Yashwant-Rajesh/Bandgap-Reference-BGR-Low-Dropout-Regulator-LDO-Circuit-/BGR_LDO_Combo_Tests/Full_Chain_LDO_Rail_Sweep.png

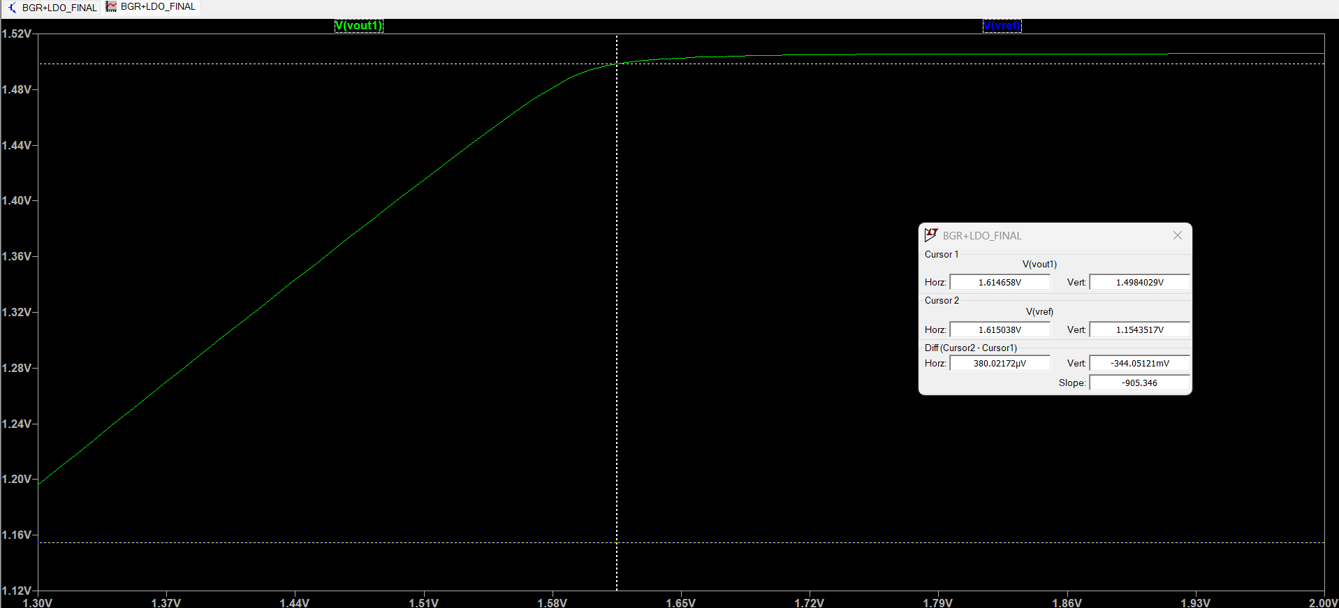
BGR_LDO_Combo_Tests/Full_Chain_LDO_Rail_Sweep.png
