Yashwant-Rajesh/Bandgap-Reference-BGR-Low-Dropout-Regulator-LDO-Circuit-/BGR_LDO_Combo_Tests/Full_Chain_Load_Transient.png

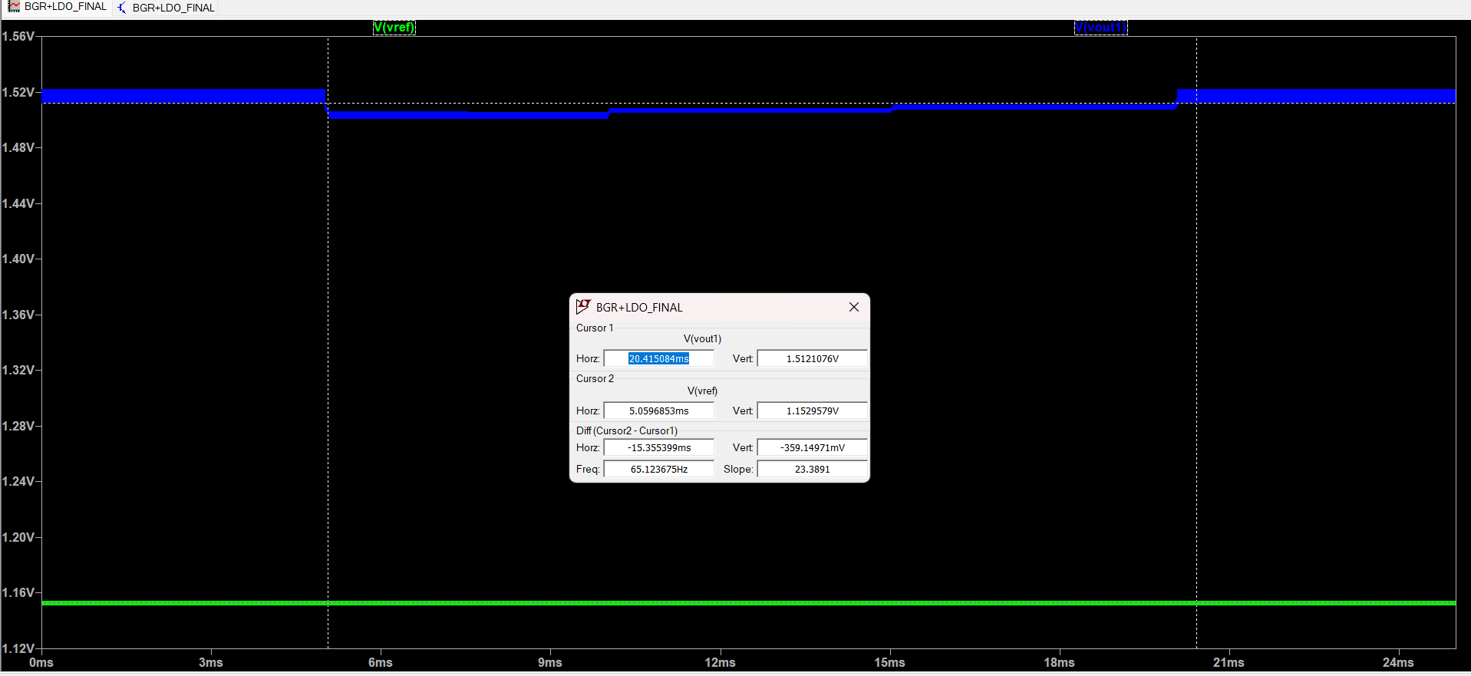
BGR_LDO_Combo_Tests/Full_Chain_Load_Transient.png
