Yashwant-Rajesh/Bandgap-Reference-BGR-Low-Dropout-Regulator-LDO-Circuit-/BGR_LDO_Combo_Tests/Full_Chain_Startup_Baseline.png

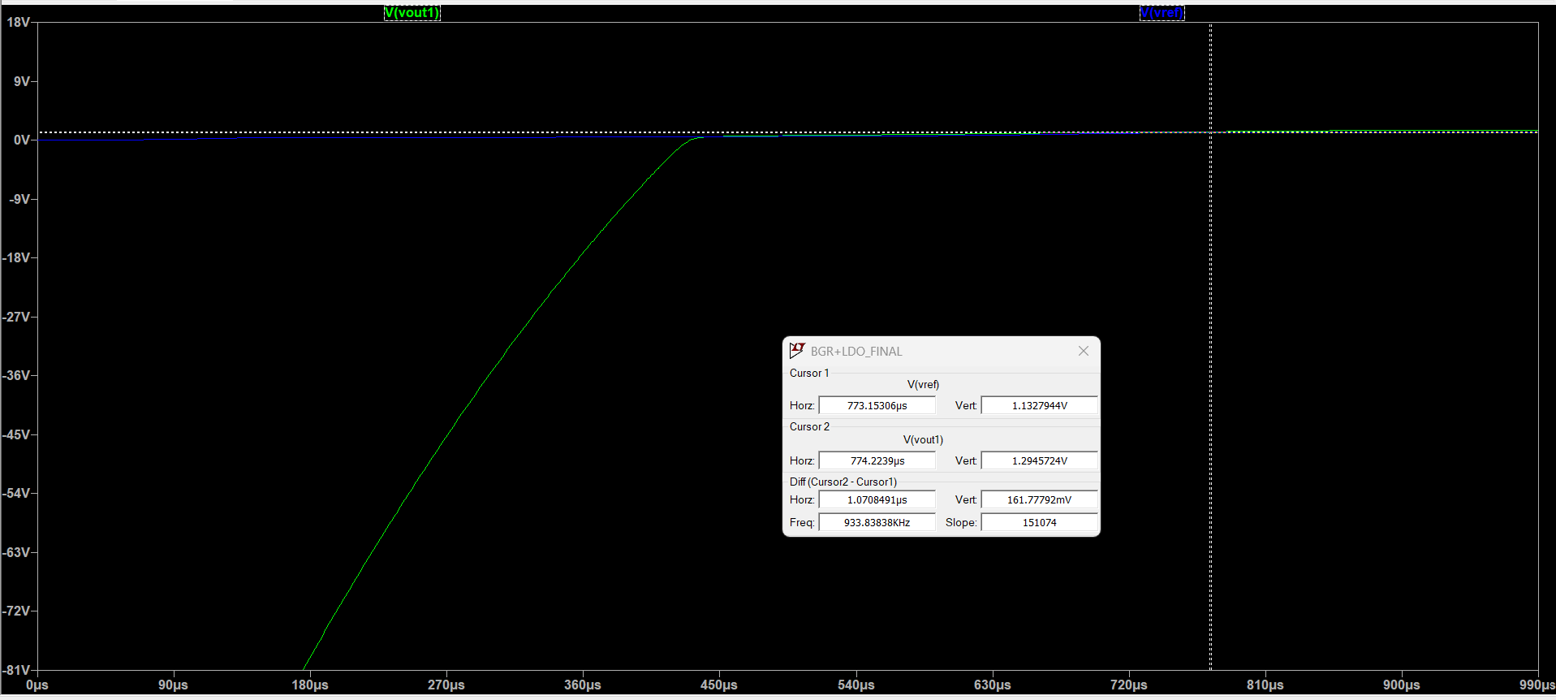
BGR_LDO_Combo_Tests/Full_Chain_Startup_Baseline.png
