Yashwant-Rajesh/Bandgap-Reference-BGR-Low-Dropout-Regulator-LDO-Circuit-/BGR_Tests/27 C Startup.png

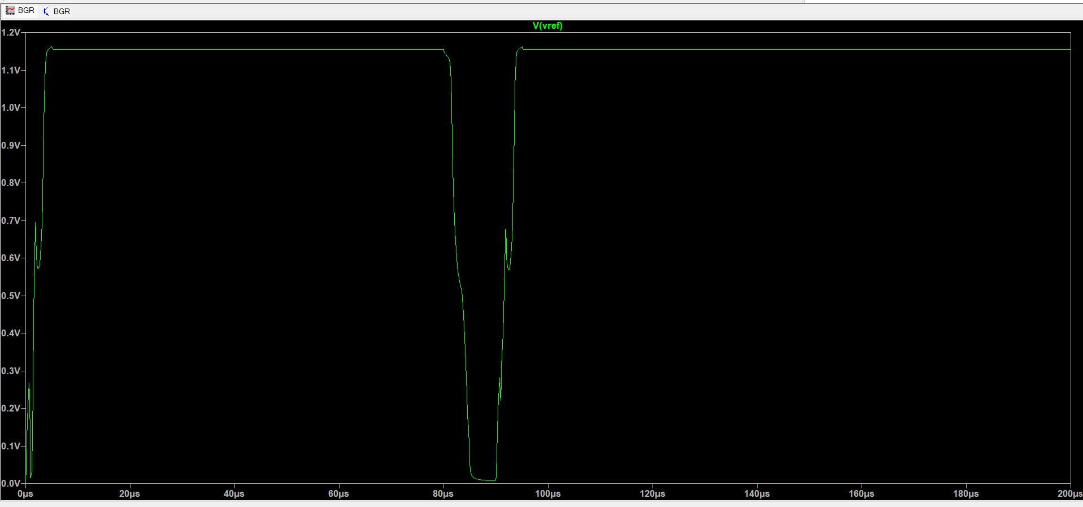
BGR_Tests/27 C Startup.png
