Yashwant-Rajesh/Bandgap-Reference-BGR-Low-Dropout-Regulator-LDO-Circuit-/BGR_Tests/Line Regulation.png

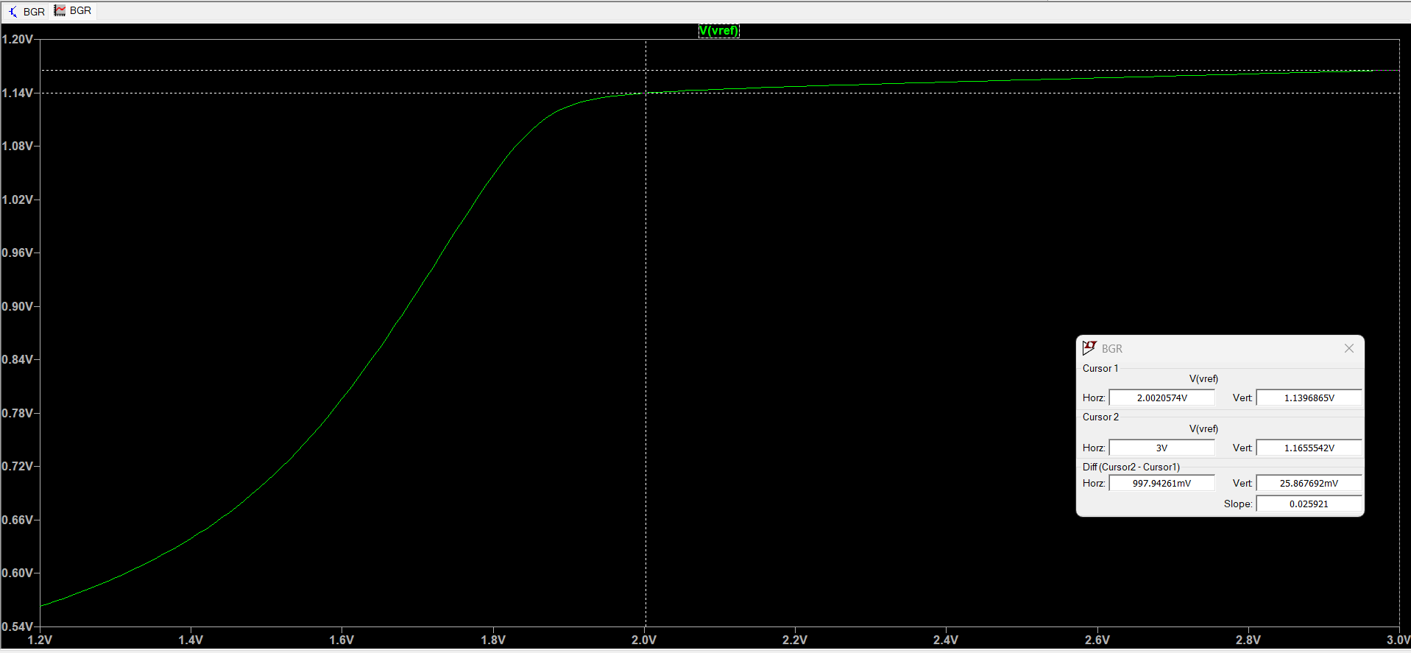
BGR_Tests/Line Regulation.png
