Yashwant-Rajesh/Bandgap-Reference-BGR-Low-Dropout-Regulator-LDO-Circuit-/BGR_Tests/Normal Ramp Startup.png

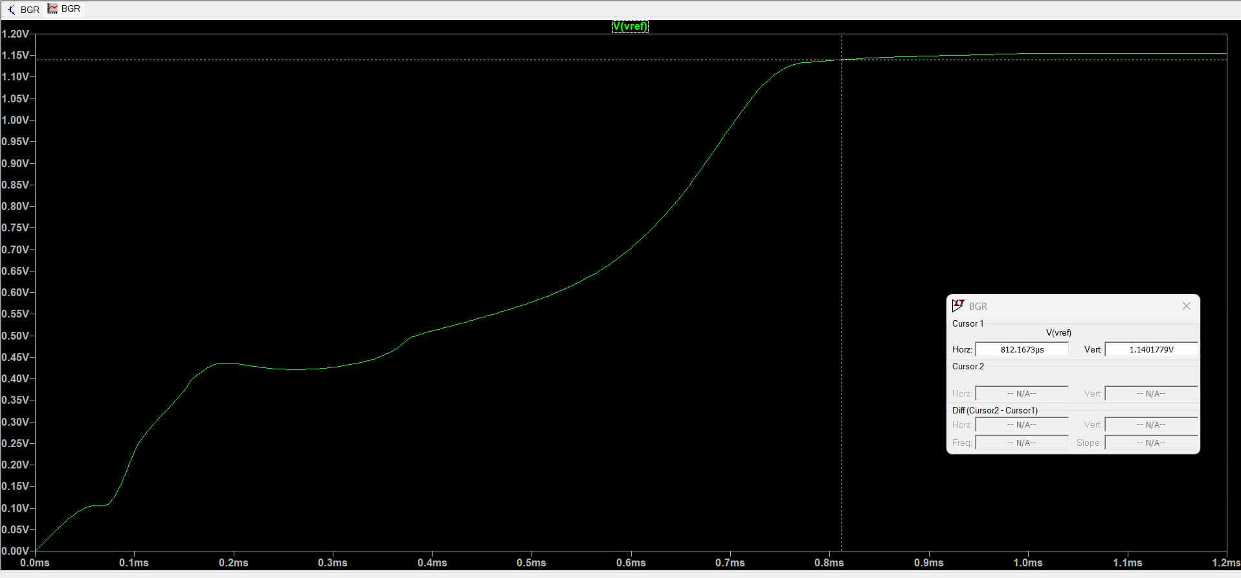
BGR_Tests/Normal Ramp Startup.png
