Yashwant-Rajesh/Bandgap-Reference-BGR-Low-Dropout-Regulator-LDO-Circuit-/BGR_Tests/Power Cycling Restart.png

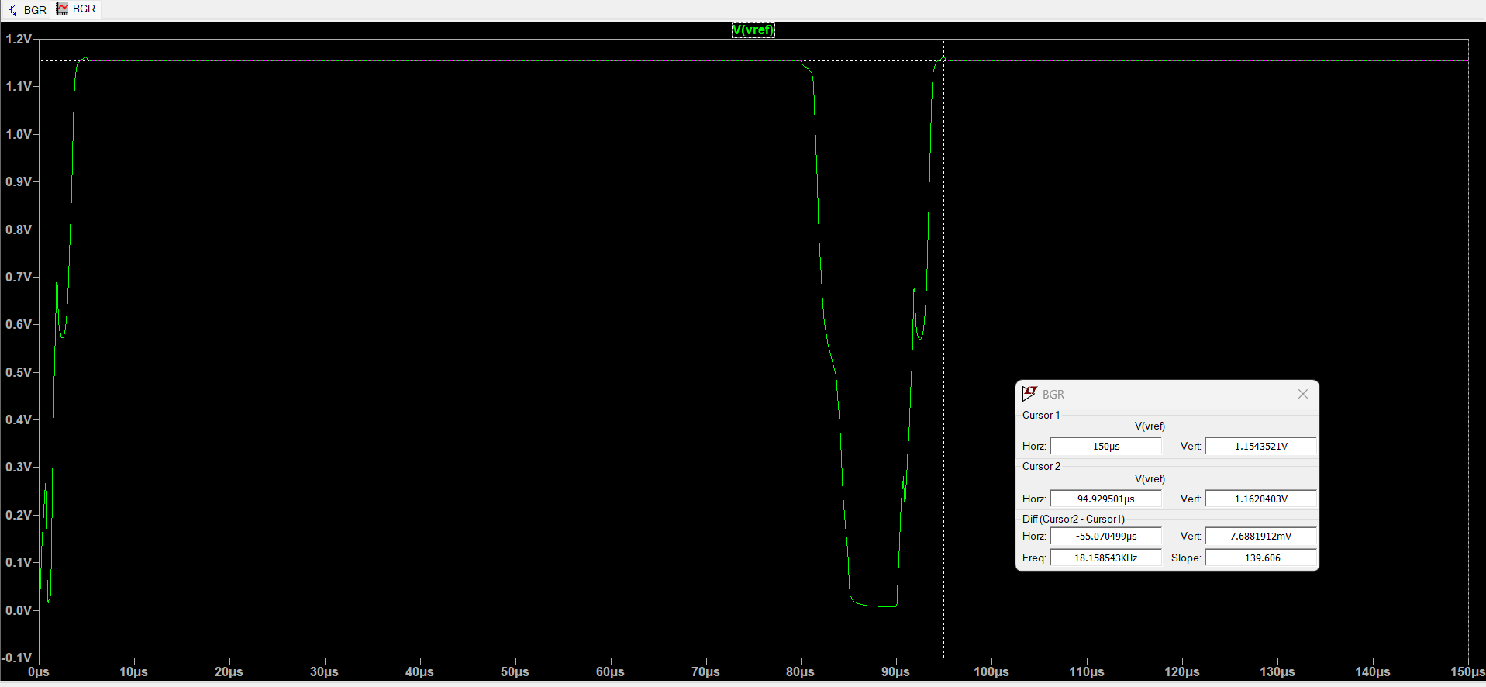
BGR_Tests/Power Cycling Restart.png
