Yashwant-Rajesh/Bandgap-Reference-BGR-Low-Dropout-Regulator-LDO-Circuit-/BGR_Tests/Temperature Coefficient.png

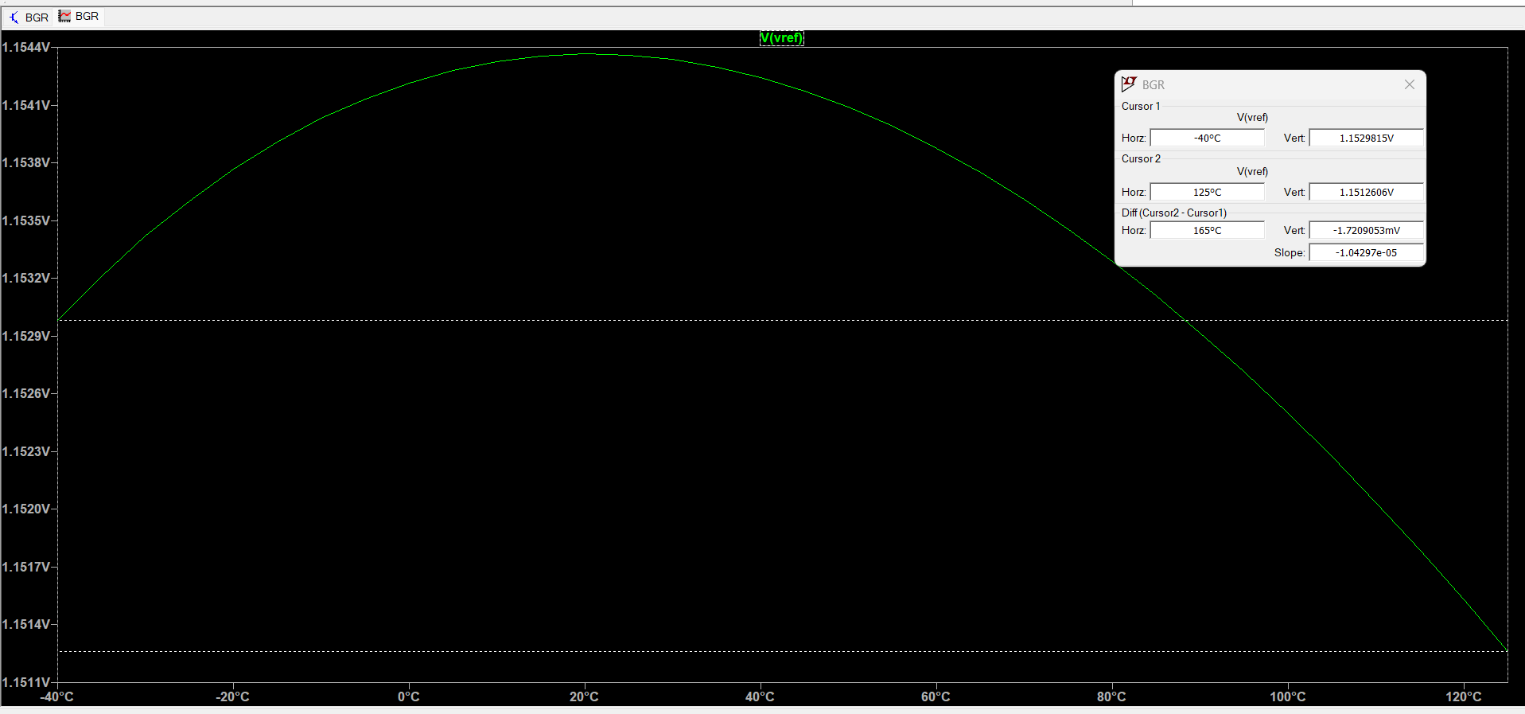
BGR_Tests/Temperature Coefficient.png
