Yashwant-Rajesh/Bandgap-Reference-BGR-Low-Dropout-Regulator-LDO-Circuit-/BGR_Tests/Worst Case Startup.png

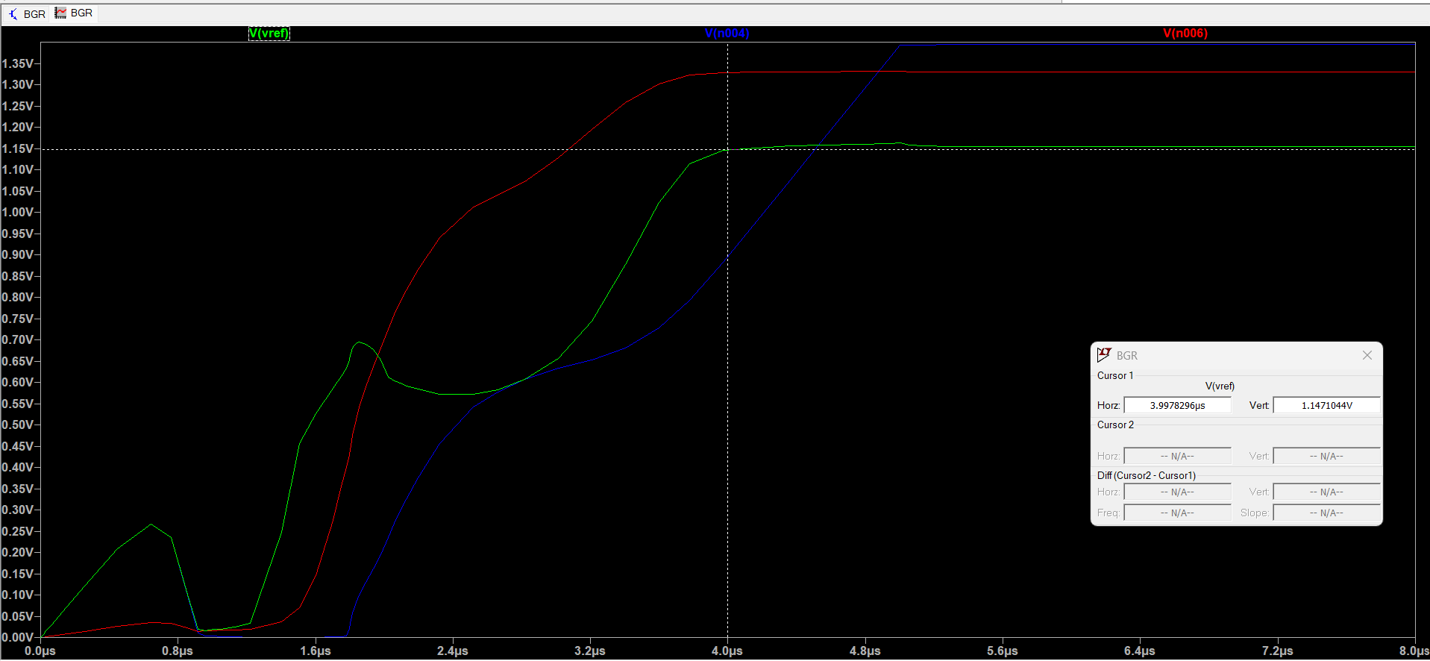
BGR_Tests/Worst Case Startup.png
