Yashwant-Rajesh/Bandgap-Reference-BGR-Low-Dropout-Regulator-LDO-Circuit-/LDO_Tests/Dropout_voltage_LDO.png

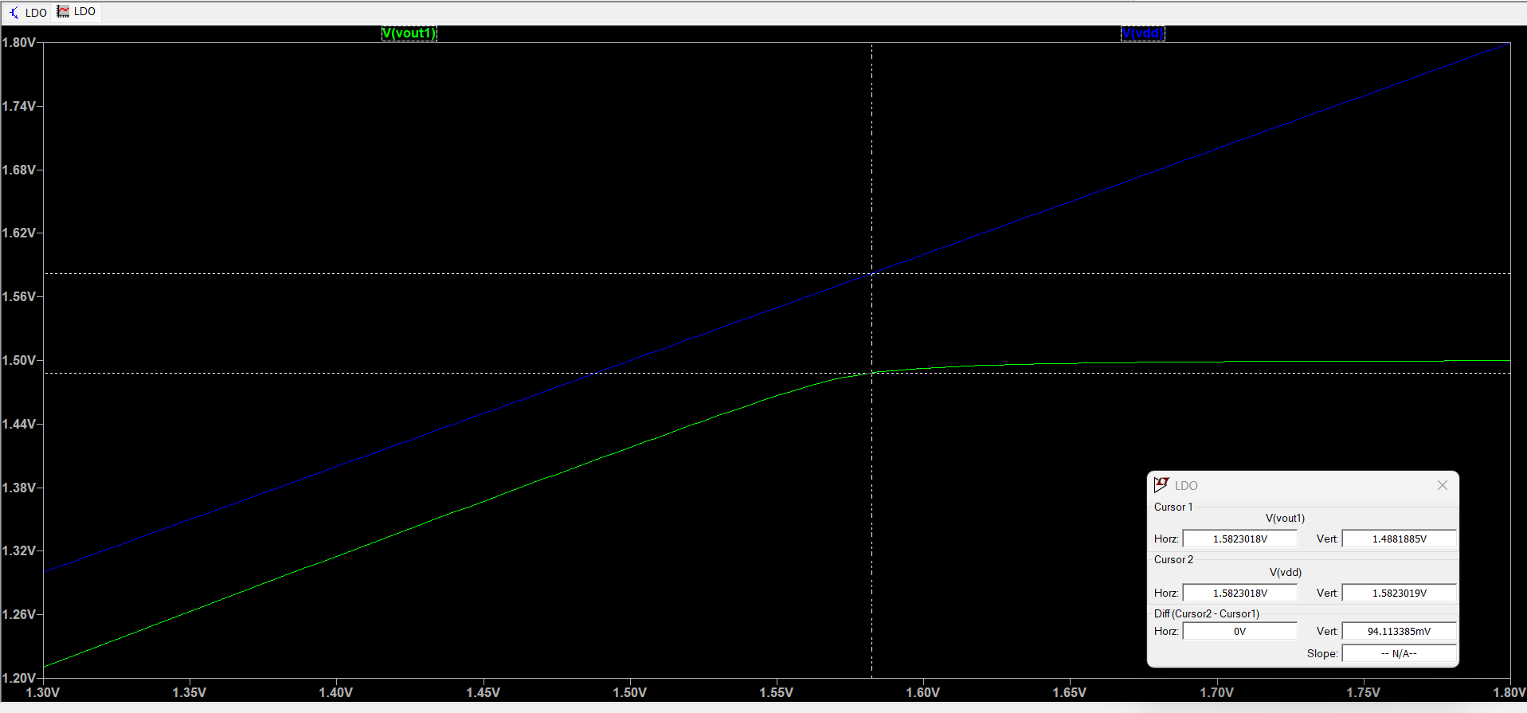
LDO_Tests/Dropout_voltage_LDO.png
