Yashwant-Rajesh/Bandgap-Reference-BGR-Low-Dropout-Regulator-LDO-Circuit-/LDO_Tests/Line_regulation_LDO.png

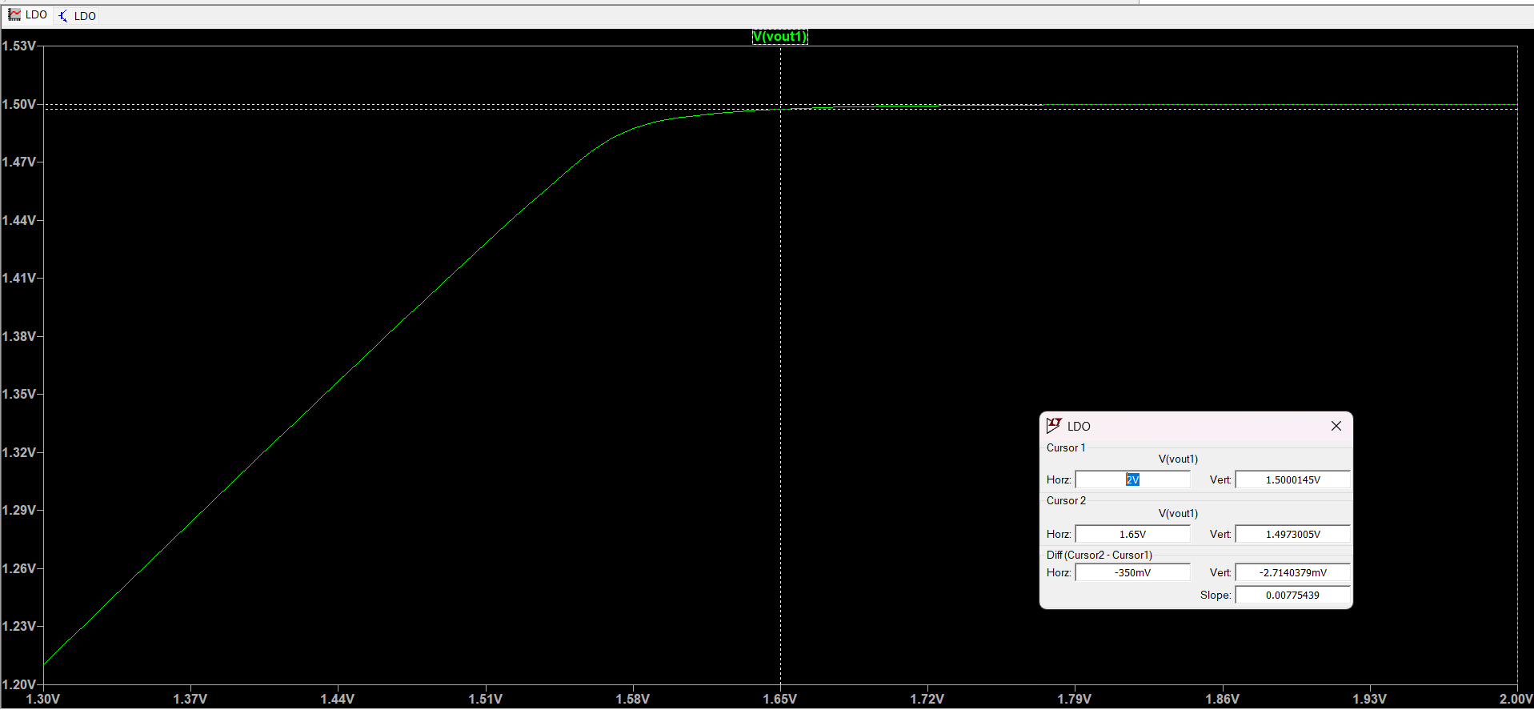
LDO_Tests/Line_regulation_LDO.png
