Yashwant-Rajesh/Bandgap-Reference-BGR-Low-Dropout-Regulator-LDO-Circuit-/LDO_Tests/Line_Transient_LDO.png

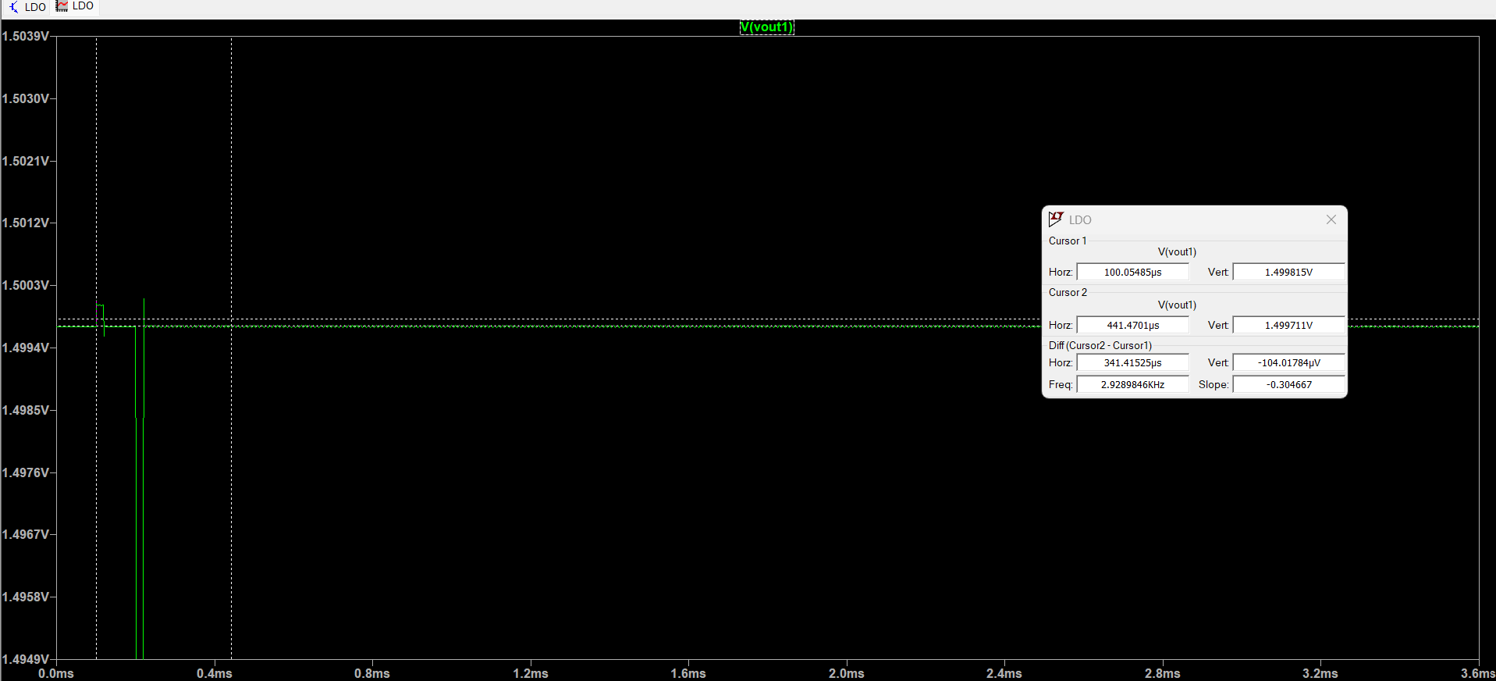
LDO_Tests/Line_Transient_LDO.png
