Yashwant-Rajesh/Bandgap-Reference-BGR-Low-Dropout-Regulator-LDO-Circuit-/LDO_Tests/Load_transient_LDO.png

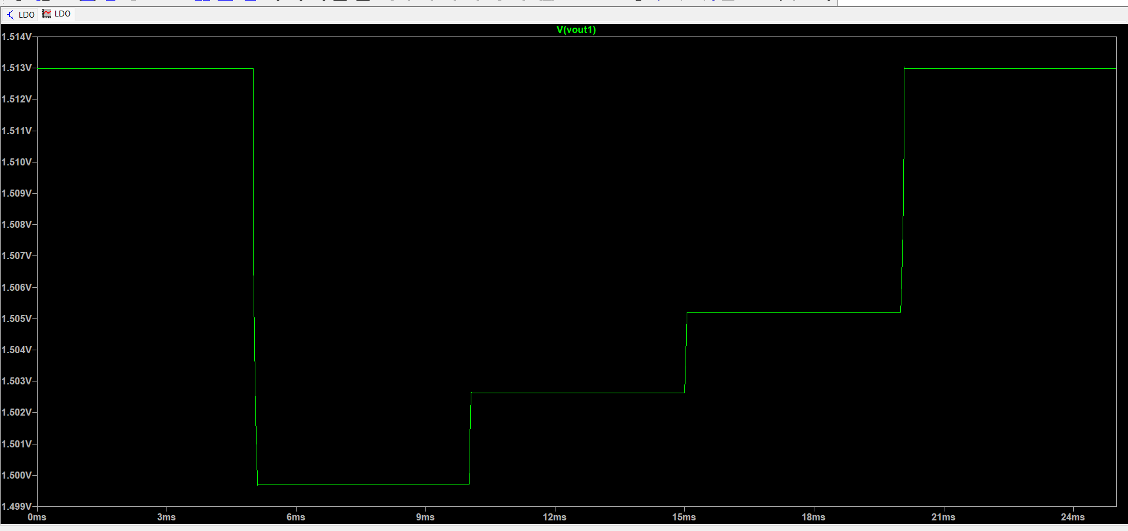
LDO_Tests/Load_transient_LDO.png
