Yashwant-Rajesh/Bandgap-Reference-BGR-Low-Dropout-Regulator-LDO-Circuit-/LDO_Tests/PSRR_LDO.png

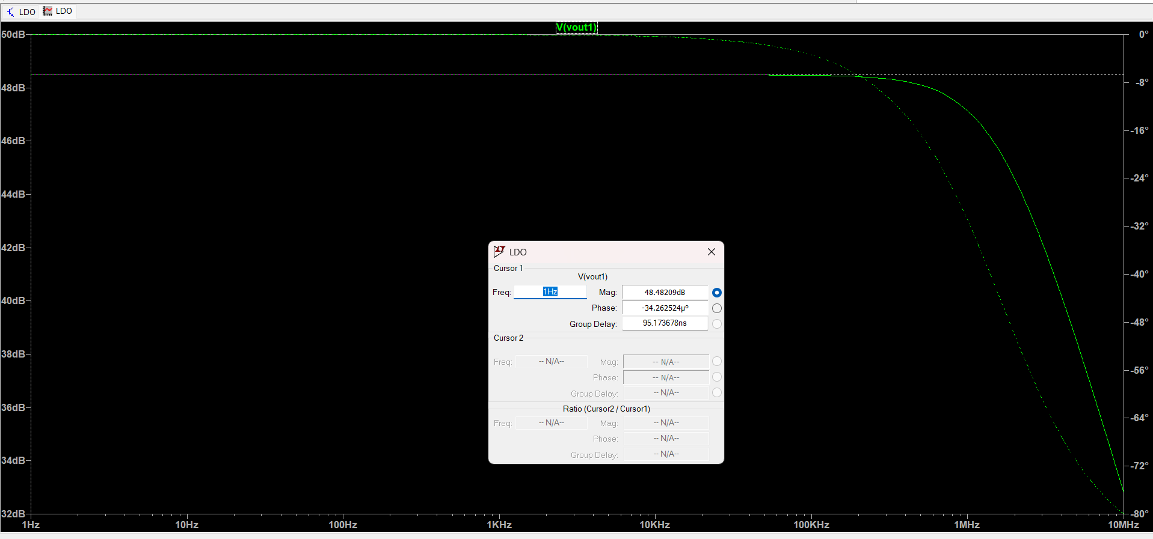
LDO_Tests/PSRR_LDO.png
