Yashwant-Rajesh/Bandgap-Reference-BGR-Low-Dropout-Regulator-LDO-Circuit-/LDO_Tests/Startup_transient_LDO.png

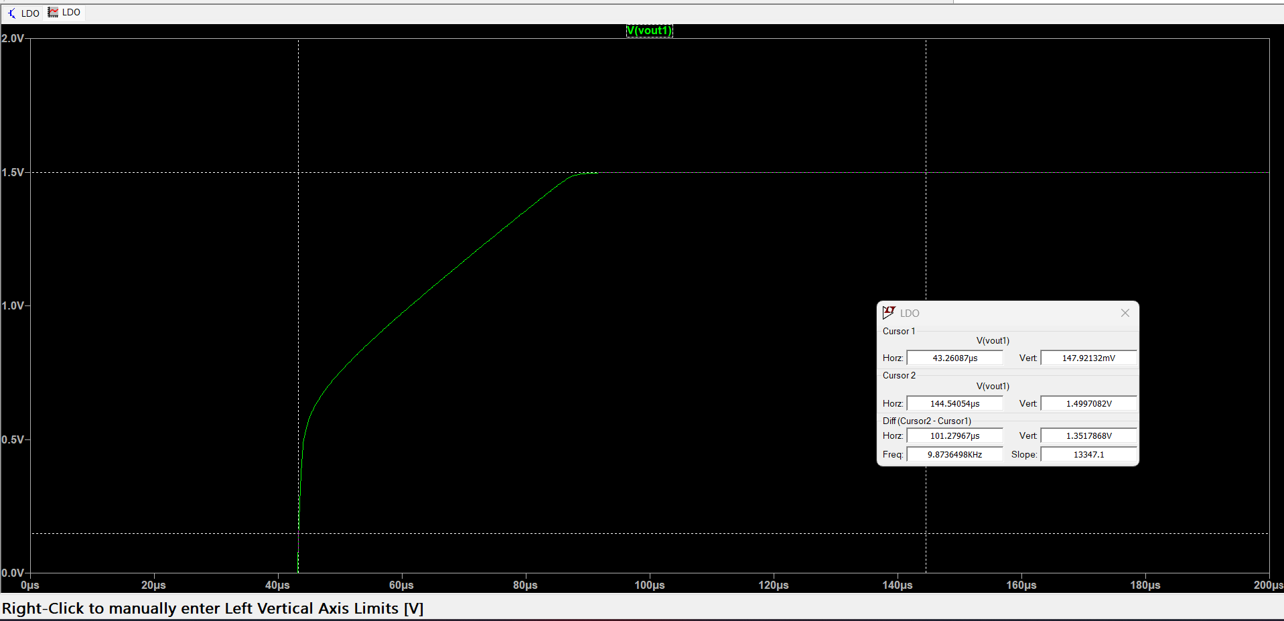
LDO_Tests/Startup_transient_LDO.png
