Yashwant-Rajesh/Bandgap-Reference-BGR-Low-Dropout-Regulator-LDO-Circuit-/Schematics/BGR.asc

M1: cmosp; l=2u w=50u
M2: cmosp; l=2u w=50u
M3: cmosp; l=2u w=50u
M4: cmosn; l=4u w=20u
M5: cmosn; l=4u w=20u
M6: cmosn; l=1u w=20u
M7: cmosn; l=1u w=20u
M8: cmosp; l=1u w=80u
M9: cmosp; l=1u w=80u
M10: cmosp; l=1u w=80u
Q1: pnp
Q2: pnp
Q3: pnp
Q4: pnp
Q5: pnp
Q6: pnp
Q7: pnp
Q8: pnp
Q9: pnp
Q10: pnp
R1: res; 500k
R2: res; 5.4k
R3: res; 50k
V1: voltage; PWL(0 0 5u 2.5 80u 2.5); AC 1
Named nets: Vdd, 0, Vref
.include tsmc018.lib
.op
;.step temp -40 125 5
TEMP COEFFICIENT
 
When you run this .step temp -40 125 5 command, you can see how Vref
changes wrt temperature, here in this design Vref is at 1.1529 V at 
-40 degrees and 1.1512 V at 125 degrees, therefore over a 165 degree
temperature sweep, the change in voltage is about only 1.72mV.
In this design its about 10.42 ppm/ degree C
LINE REGULATION
 
The Vref starts with 1.139V at V1=2V and goes up till 1.165V at V1=3V
Therefore the difference is about 25.879mV over a 1 V , which is about 
25.88mV/V which is decent but not great
 
Command: .dc V1 1.2 3 0.01
;.dc V1 1.2 3 0.01
Worst-case startup (degenerate/zerocurrent state)
 
Command: .ic V(N004)=0 V(N006)=0 V(N005)=0 V(N008)=0
.tran 200u
V1 Vdd 0 PWL(0 0 5u 2.5 200u 2.5)
 
 
Vref starts at 0 and at 5us it gets stable to about 1.15V the V(n004)
also starts at 0 and gets stable to about 1.4V at around 6us and V(n006)
also starts at 0 and gets stable to about 1.32 V at around 4us. Therefore
the startup circuit is working as intended.
;.ic V(N004)=0 V(N006)=0 V(N005)=0 V(N008)=0
;.tran 200u
Normal-ramp startup
 
Command: V1 Vdd 0 PWL(0 0 1m 2.5)
.tran 1.2m
 
 
Smooth monotonic rise to final Vref , no overshoot,no oscillation, 
no glitch as Vdd crosses the knee voltage from test #3.(2V)
 
Works as intended
;.tran 1.2m
Power-cycling restartup
 
Command: V1 Vdd 0 PWL(0 0 5u 2.5 80u 2.5 85u 0 90u 0 95u 2.5 200u 2.5)
.tran 200u
 
This command is to check whether Vref recovers cleanly after each Vdd dip, 
not just the first power-up and there is no problem, the Vref 
recovers when Vdd recovers
 
Works as intended
;.tran 200u
Startup robustness across temp corners
 
Run A (-40°C):
.ic V(N004)=0 V(N006)=0
.temp -40
.tran 200u
 
 
Run B (27°C):
.ic V(N004)=0 V(N006)=0
.temp 27
.tran 200u
 
 
Run C (125°C):
.ic V(N004)=0 V(N006)=0
.temp 125
.tran 200u
 
 
This test is to see whether Vref settles in all the corner cases as well.
 
It does!
;.ic V(N004)=0 V(N006)=0
;.temp 125
;.tran 200u
PSRR
 
Command: 
V1 Vdd 0 PWL(0 0 5u 2.5 80u 2.5) AC 1
.ac dec 10 1 1e6
.ac dec 10 1 1e6
